ExceedLimitations/PawCare/README.md

# 🐾 PawCare — Smart IoT Pet Feeder Dashboard

A full-stack IoT system for monitoring and controlling an automatic pet feeder in real-time. Built with Node.js, Express, Socket.io, and MQTT on the backend; React + Vite on the frontend; Firebase Firestore as the cloud database; and an ESP32 microcontroller running custom Arduino firmware.

---

## Table of Contents

1. [Features](#features)
2. [Tech Stack](#tech-stack)
3. [Project Structure](#project-structure)
4. [Prerequisites](#prerequisites)
5. [Firebase Setup](#firebase-setup)
6. [Environment Variables](#environment-variables)
7. [Running Locally (Development)](#running-locally-development)
8. [Building for Production](#building-for-production)
9. [Deploying to Render (Backend)](#deploying-to-render-backend)
10. [Deploying to Netlify (Frontend-only)](#deploying-to-netlify-frontend-only)
11. [REST API Reference](#rest-api-reference)
12. [Socket.io Events](#socketio-events)
13. [MQTT Topics & Payloads](#mqtt-topics--payloads)
14. [Hardware & Wiring](#hardware--wiring)
15. [Firmware (ESP32)](#firmware-esp32)
16. [CI/CD — Automated Firmware Builds](#cicd--automated-firmware-builds)
17. [Over-the-Air (OTA) Updates](#over-the-air-ota-updates)
18. [Notification System](#notification-system)
19. [Security Model](#security-model)
20. [Troubleshooting](#troubleshooting)
21. [Changelog](#changelog)

---

## Features

| Feature | Description |
|---|---|
| **Real-time monitoring** | Live food-level gauge and device-online indicator via MQTT → Socket.io |
| **Manual dispensing** | Trigger a food dispense with a configurable portion (1–500 g) from the dashboard |
| **Physical button** | Press the on-device button to dispense; the event is logged to Firestore automatically |
| **Automated schedules** | Create, edit, enable/disable, and delete feeding schedules stored in Firestore; schedules fire even if the dashboard is closed |
| **Precise weight dispensing** | The ESP32 opens the hopper servo until the HX711 load cell confirms the target weight has dropped into the bowl |
| **Feeding history** | Logs every dispense (manual, scheduled, or physical) with timestamps and portion sizes; viewable as daily, weekly, and monthly charts |
| **Reservoir state notifications** | System alerts fire when the reservoir crosses into a new band: FULL ≥75%, SUFFICIENT 40–74%, LOW 1–39%, EMPTY 0% |
| **OS-level push notifications** | Service worker delivers real system notifications even when the tab is in the background or minimised |
| **Alerts & notifications** | Visual and OS-level warnings for food level changes, chute jams, and hardware events; persisted to Firestore with date + time |
| **Pet profile** | Store your pet's name, breed, age, birthday, and avatar photo |
| **OTA firmware updates** | Push new ESP32 firmware from the dashboard without physical access to the device |
| **Automated firmware builds** | GitHub Actions compiles `firmware.ino` on every push, updates `firmware/firmware.bin` and `firmware/version.json` automatically |
| **Overlap-safe dispensing** | A feed command that arrives while a dispense is already running (scheduled + button + duplicate MQTT, etc.) is ignored instead of resetting the state machine mid-cycle |
| **Empty-hopper detection** | If several dispense pulses in a row produce no measurable weight gain, the firmware gives up after ~3–4 s and raises a "hopper empty" alert instead of grinding through the full 35 s timeout |
| **JWT authentication** | All REST endpoints, Socket.io connections, and Netlify serverless functions require a signed JWT |
| **Rate limiting** | Login (10 req/min) and feed (30 req/min) endpoints are rate-limited |

---

## Tech Stack

| Layer | Technology | Version |
|---|---|---|
| **Backend runtime** | Node.js | ≥ 18 |
| **HTTP server** | Express | 4.x |
| **Real-time** | Socket.io | 4.x |
| **IoT messaging** | MQTT | 5.x |
| **Database** | Firebase Firestore (via `firebase-admin`) | 14.x |
| **Auth** | JSON Web Tokens (`jsonwebtoken`) | 9.x |
| **Rate limiting** | `express-rate-limit` | 8.x |
| **Frontend** | React + Vite | React 19, Vite 8 |
| **Charts** | Chart.js + `react-chartjs-2` | 4.x / 5.x |
| **Icons** | `lucide-react` | 1.x |
| **Push notifications** | Browser Service Worker (`sw.js`) | — |
| **Serverless (optional)** | Netlify Functions | — |
| **CI/CD** | GitHub Actions (`arduino-cli`) | — |
| **Dev server** | nodemon | 3.x |

---

## Project Structure

```
PawCare/
├── server.js                       # Express + Socket.io + MQTT + schedule runner
├── firmware.ino                    # ESP32 Arduino firmware (main sketch)
├── firmware/
│   ├── firmware.bin                # Compiled firmware binary (auto-generated by CI)
│   └── version.json                # OTA manifest: { "version": "x.y.z", "url": "..." }
├── .github/
│   └── workflows/
│       └── compile-firmware.yml    # CI: compiles firmware.ino → firmware.bin on every push
├── netlify/
│   └── functions/                  # Netlify serverless functions (static deployment)
│       ├── _firebase.js            # Shared Firestore initializer
│       ├── _helpers.js             # Shared response helpers + requireAuth() JWT check
│       ├── _data.js                # Unused — legacy mock-data helpers from an earlier no-DB version
│       ├── feed.js                 # POST /feed
│       ├── feedings-today.js       # GET /feedings/today
│       ├── feedings-weekly.js      # GET /feedings/weekly
│       ├── feedings-recent.js      # GET /feedings/recent
│       ├── sensor-history.js       # GET /sensor/history
│       ├── schedules.js            # GET & POST /schedules
│       ├── schedules-id.js         # PATCH & DELETE /schedules/:id
│       ├── status.js               # GET /status
│       └── profile.js              # GET & POST /profile
├── netlify.toml                    # Netlify build & redirect configuration
├── frontend/                       # React + Vite dashboard
│   ├── index.html
│   ├── vite.config.js              # Dev proxy → localhost:3000
│   ├── package.json
│   └── src/
│       ├── main.jsx
│       ├── App.jsx                 # Root component — all dashboard state & logic lives here
│       ├── index.css               # Global styles
│       ├── components/
│       │   └── MetricPanels.jsx    # Unused — not imported by App.jsx
│       └── hooks/
│           ├── useDashboard.js     # Unused — exports useNextFeed(), not imported by App.jsx
│           ├── useSocket.js        # Socket.io connection & event handlers (used)
│           └── useNotifications.js # Browser notification permission & SW delivery (used)
│   └── public/
│       └── sw.js                   # Service Worker: OS-level push notification handler
├── package.json                    # Server (backend) dependencies
├── .env.example                    # Template for your .env file
└── .gitignore
```

> **Note:** `netlify/functions/_data.js`, `frontend/src/components/MetricPanels.jsx`, and `frontend/src/hooks/useDashboard.js` are currently unreferenced by any code path — leftovers from an earlier iteration of the dashboard. They're harmless to leave in place, but don't expect edits there to have any effect until something actually imports them.

---

## Prerequisites

- [Node.js](https://nodejs.org/) **v18 or later** (both backend and frontend build)
- npm (bundled with Node)
- A **Firebase project** with Firestore enabled (see [Firebase Setup](#firebase-setup))
- An MQTT broker — the public HiveMQ broker (`broker.hivemq.com:1883`) works for development; use a private broker in production
- *(For firmware)* Arduino IDE with ESP32 board support and the libraries listed in [Firmware](#firmware-esp32)

---

## Firebase Setup

1. Go to [Firebase Console](https://console.firebase.google.com/) and create a new project (or use an existing one).
2. Enable **Cloud Firestore** in Native mode.
3. Go to **Project Settings → Service Accounts** and click **Generate new private key**. Save the downloaded JSON file as `firebase-service-account.json` in the project root.
4. In your `.env` file set:
   ```env
   GOOGLE_APPLICATION_CREDENTIALS=./firebase-service-account.json
   ```
   > **Tip for PaaS (Render, Railway, etc.):** Instead of uploading the file, paste the entire JSON content as a single-line string into the `FIREBASE_SERVICE_ACCOUNT` environment variable. The server reads this automatically.

The server will verify the Firestore connection on startup and crash with a helpful error if it cannot reach the database.

### Firestore Collections Used

| Collection | Purpose |
|---|---|
| `feedings` | One document per dispense event |
| `schedules` | One document per feeding schedule |
| `sensor_logs` | Sensor telemetry; `latest` document always holds the most recent reading |
| `notifications` | Persisted alert/notification records (includes `type`, `title`, `message`, `time`, `date`, `id`) |
| `config/profile` | Single document storing the pet profile |

---

## Environment Variables

Copy `.env.example` to `.env` and fill in your values:

```bash
cp .env.example .env
```

| Variable | Default | Required | Description |
|---|---|---|---|
| `PORT` | `3000` | No | HTTP server port |
| `MQTT_BROKER` | `mqtt://broker.hivemq.com:1883` | No | MQTT broker URL |
| `MQTT_TOPIC_STATUS` | `pawfeed/device01/status` | No | Hardware status updates |
| `MQTT_TOPIC_SENSOR` | `pawfeed/device01/sensor` | No | Sensor readings |
| `MQTT_TOPIC_CMD` | `pawfeed/device01/command` | No | Commands sent to hardware |
| `MQTT_TOPIC_ALERTS` | `pawfeed/device01/alerts` | No | Device alert messages |
| `MQTT_TOPIC_FEED_LOG` | `pawfeed/device01/feed_log` | No | Physical button feed events from device |
| `MQTT_TOPIC_OTA_STATUS` | `pawfeed/device01/ota_status` | No | OTA progress updates |
| `GOOGLE_APPLICATION_CREDENTIALS` | `./firebase-service-account.json` | **Yes*** | Path to Firebase service account JSON |
| `FIREBASE_SERVICE_ACCOUNT` | *(empty)* | **Yes*** | Firebase service account JSON as a string (PaaS alternative to the file) |
| `ADMIN_USER` | *(none)* | **Yes** | Dashboard login username |
| `ADMIN_PASS` | *(none)* | **Yes** | Dashboard login password |
| `JWT_SECRET` | *(none)* | **Yes** | JWT signing secret (use 32+ random characters) |
| `TZ` | `Asia/Manila` | No | Timezone for schedule execution and date labels |

> **\*** Either `GOOGLE_APPLICATION_CREDENTIALS` (file path) or `FIREBASE_SERVICE_ACCOUNT` (JSON string) must be provided. The server exits immediately if Firebase cannot initialize.

> **Security:** The server **refuses to start** if `ADMIN_USER`, `ADMIN_PASS`, or `JWT_SECRET` are missing. Never use default or weak values in production.

---

## Running Locally (Development)

### 1. Install dependencies

```bash
# Project root — backend deps
npm install

# Frontend deps
cd frontend
npm install
cd ..
```

### 2. Configure environment

```bash
cp .env.example .env
# Edit .env and fill in ADMIN_USER, ADMIN_PASS, JWT_SECRET, and Firebase credentials
```

### 3. Start the backend

```bash
npm run dev          # uses nodemon — auto-restarts on file changes
```

The backend runs at **http://localhost:3000**.

### 4. Start the frontend (separate terminal)

```bash
cd frontend
npm run dev          # Vite dev server — usually http://localhost:5173
```

The Vite dev server proxies all `/feed`, `/schedules`, `/status`, and socket requests to `localhost:3000`, so CORS is not an issue in development.

> **No hardware?** There is currently no simulated/demo data mode in the frontend — without a device publishing to MQTT, the dashboard will show zeroed-out stats (0% food level, no recent feedings) rather than synthetic data. `netlify/functions/_data.js` contains leftover mock-data generators from an earlier iteration that did this, but nothing imports it today.

---

## Building for Production

```bash
cd frontend
npm run build        # outputs to frontend/dist/
```

In production mode the Express server at the project root serves the built React app from `frontend/dist/`. You only need to run the backend:

```bash
npm start            # runs node server.js
```

---

## Deploying to Render (Backend)

Render is the recommended platform for the full-stack deployment (backend + Firebase + MQTT).

1. Push the repo to GitHub.
2. Create a new **Web Service** on [Render](https://render.com/) pointing to your repo.
3. Set the build command to:
   ```
   npm install && cd frontend && npm install && npm run build
   ```
4. Set the start command to:
   ```
   node server.js
   ```
5. Add all environment variables from the table above in the Render dashboard.
6. For Firebase credentials on Render, paste the entire service account JSON into the `FIREBASE_SERVICE_ACCOUNT` environment variable.

The live URL (`https://pawcare-rcd9.onrender.com`) is already embedded in the firmware as the OTA endpoint.

---

## Deploying to Netlify (Frontend-only)

Netlify is supported for a **static + serverless** deployment where the frontend and API functions are both served from Netlify's CDN (no persistent backend — MQTT real-time is not available in this mode).

```bash
# Install Netlify CLI
npm install -g netlify-cli

# Authenticate and link your site
netlify login
netlify link

# Run locally with Netlify Functions
npm run netlify-dev
```

`netlify.toml` maps all API routes (e.g., `/feed`, `/schedules`) to the corresponding functions in `netlify/functions/`. The SPA fallback rule serves `index.html` for all unmatched paths.

> **Note:** Socket.io real-time updates and the schedule runner are only available with the full Node.js backend on Render (or equivalent). The Netlify deployment is suitable for read-only or limited-write dashboards without live sensor streaming.

> **⚠️ No `/login` function exists on Netlify.** Every Netlify function requires the same `Authorization: Bearer <JWT>` header that `server.js` enforces (see [Security Model](#security-model)), but `netlify/functions/` has no login handler and `netlify.toml` has no redirect for `/login` — so the dashboard's login screen has nothing to submit to and will 404 on a Netlify-only deployment. To use this mode today you need to either:
> - Mint a token from a running Node backend's `POST /login` (same `JWT_SECRET` configured on both sides) and set it manually via the browser console: `localStorage.setItem('pawcare_auth', '<token>')`, or
> - Add a `netlify/functions/login.js` that mirrors `server.js`'s `/login` handler and wire it up in `netlify.toml`.
>
> Until one of those is done, treat the Netlify deployment as a functions-only backend for a separately-hosted frontend/session, not a fully self-contained deployment.

---

## REST API Reference

All endpoints except `GET /health`, `POST /login`, `GET /firmware/version.json`, and `GET /firmware/firmware.bin` require a `Bearer <token>` header.

### Authentication

| Method | Endpoint | Description |
|---|---|---|
| `POST` | `/login` | Obtain a JWT. Body: `{ "username": "admin", "password": "..." }`. Returns `{ "success": true, "token": "..." }`. Token expires in 8 hours. |
| `GET` | `/health` | Liveness probe. Returns `{ "ok": true, "ts": <epoch_ms> }`. |

### Feeding

| Method | Endpoint | Auth | Description |
|---|---|---|---|
| `POST` | `/feed` | ✅ | Dispatch a food dispense. Body: `{ "portion": 80, "type": "manual" }`. Portion clamped to 1–500 g; defaults to 45 g if omitted or invalid. Rate-limited to 30 req/min. |
| `GET` | `/feedings/today` | ✅ | Today's total feed count and grams. |
| `GET` | `/feedings/recent` | ✅ | Last 50 feeding records (newest first). |
| `GET` | `/feedings/weekly` | ✅ | Daily totals for the past 7 days (zero-padded). |
| `GET` | `/feedings/monthly` | ✅ | Daily totals for the past 30 days (zero-padded). |
| `GET` | `/feedings/daily` | ✅ | Hourly breakdown for today. |

### Sensor & Status

| Method | Endpoint | Auth | Description |
|---|---|---|---|
| `GET` | `/status` | ✅ | Latest sensor snapshot from Firestore. |
| `GET` | `/sensor/history` | ✅ | Daily average food level for the past 7 days. |

### Schedules

| Method | Endpoint | Auth | Description |
|---|---|---|---|
| `GET` | `/schedules` | ✅ | List all feeding schedules. |
| `POST` | `/schedules` | ✅ | Create a new schedule. Body: `{ "label": "Morning", "time": "08:00", "portion_g": 80, "days": "daily" }`. `days` accepts `"daily"`, `"weekdays"`, or `"weekends"`. |
| `PATCH` | `/schedules/:id` | ✅ | Update a schedule field. Any subset of `{ label, time, portion_g, days, enabled }`. |
| `DELETE` | `/schedules/:id` | ✅ | Delete a schedule. |

### Notifications

| Method | Endpoint | Auth | Description |
|---|---|---|---|
| `GET` | `/notifications` | ✅ | Last 100 notifications (newest first). |
| `POST` | `/notifications` | ✅ | Save a notification. Body: `{ "id", "type", "title", "message", "time", "date" }`. |
| `DELETE` | `/notifications` | ✅ | Clear all notifications. |
| `DELETE` | `/notifications/:id` | ✅ | Dismiss a single notification. |

### Pet Profile

| Method | Endpoint | Auth | Description |
|---|---|---|---|
| `GET` | `/profile` | ✅ | Retrieve pet profile (`name`, `breed`, `avatar`, `birthday`, `age`). |
| `POST` | `/profile` | ✅ | Save/update pet profile. Accepts Base64 avatar image (up to 10 MB). |

### Firmware (OTA)

| Method | Endpoint | Auth | Description |
|---|---|---|---|
| `GET` | `/firmware/version.json` | ❌ | Returns the OTA version manifest. |
| `GET` | `/firmware/firmware.bin` | ❌ | Streams the compiled firmware binary to the ESP32. |
| `POST` | `/firmware/update` | ✅ | Sends an `ota_update` MQTT command to trigger an OTA check on the device. |

---

## Socket.io Events

The frontend connects with its JWT in the handshake auth: `{ auth: { token } }`.

### Events emitted **by the server** to clients

| Event | Payload | Description |
|---|---|---|
| `status` | `{ food_level, jammed, last_dispensed_g, dispense_success, bowl_weight, online, fw_version }` | Real-time sensor update from device |
| `feeding_done` | `{ id, timestamp, portion_g, type, label? }` | Confirmed dispense (any source) |
| `alert` | `{ level: "error" \| "warning", message: "..." }` | Hardware alert from device |
| `mqtt_status` | `{ connected: true \| false }` | MQTT broker connectivity change |
| `ota_status` | `{ status, version?, error? }` | OTA firmware update progress |
| `tare_ack` | `{ timestamp }` | Scale tare command acknowledged |
| `error` | `{ message }` | Socket-level error (e.g., rate limit exceeded) |

### Events emitted **by clients** to the server

| Event | Payload | Description |
|---|---|---|
| `feed` | `{ portion: 80, type: "manual" }` | Trigger a dispense (rate-limited: 30/min) |
| `tare` | *(none)* | Zero the load cell scale |

---

## MQTT Topics & Payloads

All topics use the prefix configured via `MQTT_TOPIC_*` environment variables (default: `pawfeed/device01`).

### Server → Device (`/command`)

```json
{ "action": "feed",       "portion_g": 80 }
{ "action": "tare" }
{ "action": "ota_update" }
```

### Device → Server (`/status`) — sent once on MQTT connect

```json
{ "food_level": 72, "jammed": false, "online": true, "fw_version": "1.3.17" }
```

### Device → Server (`/sensor`) — periodic telemetry (every ~4 s, and during a dispense)

```json
{
  "food_level": 72,
  "jammed": false,
  "last_dispensed_g": 50.1,
  "dispense_success": true,
  "bowl_weight": 122.5,
  "fw_version": "1.3.17"
}
```

### Device → Server (`/feed_log`) — Physical button only

```json
{ "type": "physical", "portion_g": 100 }
```

### Device → Server (`/alerts`)

```json
{ "alert_message": "Hopper jammed — check dispenser chute" }
```

### Device → Server (`/ota_status`)

The `status` field is one of `checking`, `downloading`, `up_to_date`, `success`, or `failed`. `version` and `error` are only present when relevant:

```json
{ "status": "checking" }
{ "status": "downloading", "version": "1.3.17" }
{ "status": "up_to_date",  "version": "1.3.17" }
{ "status": "success",     "version": "1.3.17" }
{ "status": "failed",      "error": "HTTP 404" }
{ "status": "failed",      "error": "Malformed version.json" }
```

---

## Hardware & Wiring

Flash `firmware.ino` to your ESP32 and wire the components according to the table below.

| Component | ESP32 Pin | Notes |
|---|---|---|
| **Servo Motor (Dispenser gate)** | `GPIO 13` | Controls chute opening via `ESP32Servo` / ledc PWM |
| **HC-SR04 Ultrasonic — Trigger** | `GPIO 5` | Measures hopper fill level |
| **HC-SR04 Ultrasonic — Echo** | `GPIO 18` | Use a 5V → 3.3V logic level shifter |
| **IR Jam Sensor (FC-51 / break-beam)** | `GPIO 19` | `INPUT_PULLUP`; `IR_JAM_STATE = LOW` for reflectance modules, `HIGH` for break-beam |
| **HX711 Load Cell — DOUT** | `GPIO 21` | Scale data output |
| **HX711 Load Cell — SCK** | `GPIO 22` | Scale clock |
| **Piezo Buzzer** | `GPIO 4` | Non-blocking PWM via ledc; auditory feedback on dispense and errors |
| **Status LED** | `GPIO 2` | Solid = online; fast blink = WiFi portal open |
| **Alert/Error LED** | `GPIO 15` | Flashes on jam or dispense failure |
| **Manual Dispense Button** | `GPIO 14` | Short press = dispense; hold 3 s at boot = WiFi reset |

> **LEDC channel/timer gotcha:** the servo (`SERVO_CHANNEL`) and buzzer (`BUZZER_CHANNEL`) are both driven via the ESP32 core 2.x `ledcSetup`/`ledcWrite`/`ledcWriteTone` API, **not** the `ESP32Servo` library. On this core, LEDC channels share an underlying timer in pairs: `timer = (channel/2) % 4`. Channels `0` and `1` share a timer — if the servo and buzzer were ever assigned to that pair (as they were until firmware v1.3.16), `ledcWriteTone()` beeping the buzzer would silently reprogram the shared timer's frequency out from under the servo's 50 Hz PWM signal, corrupting it (typically the servo stops responding entirely) for as long as the tone lasted. `SERVO_CHANNEL = 2` and `BUZZER_CHANNEL = 0` currently sit on separate timers — if you ever add another `ledcSetup()`-based peripheral, pick a channel outside `{0,1}` (whichever timer the buzzer/servo don't already use) or move to `ESP32Servo`, which manages its own timer allocation.

### Hopper Ultrasonic Calibration

The firmware maps the HC-SR04 distance reading to a 0–100% food level using Arduino's `map()` + `constrain()`:

```cpp
level = constrain(map(dist, HOPPER_FULL_CM, HOPPER_EMPTY_CM, 100, 0), 0, 100);
```

| Constant | Value | Meaning |
|---|---|---|
| `HOPPER_FULL_CM` | `2 cm` | Distance sensor → food surface when hopper is **full** (100%) |
| `HOPPER_EMPTY_CM` | `9 cm` | Distance sensor → hopper bottom when **completely empty** (0%) |

> **Calibration history:**
> - Originally `20 cm` — caused ~50% to display when actually empty
> - Updated to `11 cm` — caused ~22% to display when actually empty  
> - Recalibrated to `9 cm` — correctly maps the physical empty reading to 0%

**To recalibrate:** Empty the hopper completely, open the lid, and read the distance from the Arduino Serial Monitor. Set `HOPPER_EMPTY_CM` to that value (or slightly lower so `constrain()` clamps any variation to 0%).

**Back-calculation formula** (if you know the displayed % but not the cm):
```
dist = HOPPER_FULL_CM + (1 - displayed% / 100) × (HOPPER_EMPTY_CM - HOPPER_FULL_CM)
```

### Servo Gate Calibration

| Constant | Value | Meaning |
|---|---|---|
| `SERVO_CLOSED` | `90°` | Gate sealed — food held in hopper |
| `SERVO_OPEN` | `20°` | Gate fully open — food falls to bowl |

Adjust these angles if your servo mechanical linkage is different.

---

## Firmware (ESP32)

### Required Arduino Libraries

Install these via Arduino Library Manager (Sketch → Include Library → Manage Libraries):

| Library | Author |
|---|---|
| `WiFiManager` | tzapu |
| `PubSubClient` | Nick O'Leary |
| `ArduinoJson` | Benoit Blanchon |
| `HX711 Arduino Library` | bogde |

The following are built into the ESP32 Arduino core and do not need separate installation: `WiFi`, `Preferences`, `HTTPUpdate`, `WiFiClientSecure`.

> **`ESP32Servo` is not actually used.** `compile-firmware.yml` still installs it and it doesn't hurt to have on your machine, but `firmware.ino` doesn't `#include` it — the servo gate is driven directly via the ESP32 core's built-in `ledcSetup`/`ledcAttachPin`/`ledcWrite` API (see `setServoAngle()`). See the LEDC timer-sharing note in [Hardware & Wiring](#hardware--wiring) if you're touching servo/buzzer PWM code.

### First Boot — WiFi Setup

On first boot (or after a WiFi reset), the ESP32 opens a captive-portal access point:

- **SSID:** `PawCare-Setup`
- **Password:** `pawcare123`

Connect with your phone or laptop, open any browser, and you will be redirected to a configuration page where you can enter:

- Your home Wi-Fi SSID and password
- MQTT Server address
- MQTT Port
- Topic Prefix (e.g., `pawfeed/device01`)

All settings are saved to ESP32 NVS flash and survive reboots. To reset WiFi and re-open the portal, hold the button on `GPIO 14` for **3 seconds at boot**.

### Key Firmware Constants

| Constant | Current Value | Description |
|---|---|---|
| `FIRMWARE_VERSION` | `"1.3.17"` | Must match `firmware/version.json` to avoid boot-loop OTA |
| `OTA_VERSION_URL` | `https://pawcare-rcd9.onrender.com/firmware/version.json` | Where the device checks for updates |
| `HOPPER_FULL_CM` | `2` | HC-SR04 reading (cm) when hopper is full → 100% |
| `HOPPER_EMPTY_CM` | `9` | HC-SR04 reading (cm) when hopper is empty → 0% |
| `calibration_factor` | `418.95` | HX711 scale calibration; adjust until `1 g = 1 g` in Serial Monitor |
| `targetWeight` | `45` g | Default portion if no `portion_g` arrives from dashboard |
| `emptyThreshold` | `10` % | Food level below which hopper is considered "empty" for LED/alert logic |
| `jamTimeout` | `1500` ms | Time IR sensor must be blocked before declaring a jam |
| `IR_JAM_STATE` | `LOW` | Flip to `HIGH` for break-beam IR sensors |
| `SERVO_CLOSED` | `90°` | Servo angle for sealed gate |
| `SERVO_OPEN` | `20°` | Servo angle for fully open gate |

### Non-Blocking Dispense State Machine

`handleDispenser()` runs on every `loop()` iteration and drives dispensing through a state machine (`DISPENSE_IDLE → DISPENSE_INIT → DISPENSE_SETTLE → DISPENSE_PULSE_OPEN ⇄ DISPENSE_PULSE_SETTLE → DISPENSE_FINAL_SETTLE → DISPENSE_EVALUATE → DISPENSE_IDLE`) instead of blocking with `delay()`. Each pulse briefly opens the gate for a duration proportional to the remaining weight, then closes it and waits for the HX711 reading to settle before deciding whether to pulse again.

| Constant | Value | Description |
|---|---|---|
| `PULSE_MS_PER_GRAM` | `8` ms/g | Pulse duration scales with grams remaining |
| `PULSE_MIN_MS` / `PULSE_MAX_MS` | `100` / `300` ms | Clamp range for a single pulse's open duration |
| `PULSE_SETTLE_MS` | `700` ms | Wait after closing the gate for the load cell reading to stabilize before pulsing again |
| `DISPENSE_DONE_G` | `0.5` g | Remaining weight below which the dispense is considered complete |
| `DISPENSE_STALL_PULSES` | `4` | Consecutive pulses with negligible weight gain before aborting as "hopper empty" (v1.3.17+) |
| `DISPENSE_STALL_GAIN_G` | `1.0` g | Minimum weight gain per pulse needed to reset the stall counter (v1.3.17+) |
| *(hard timeout)* | `35000` ms | Absolute ceiling on any single dispense attempt, regardless of state |

**Two safeguards worth knowing about if you're debugging a stuck feeder:**
- **Overlap guard (v1.3.16+):** a feed command that arrives while `dispState != DISPENSE_IDLE` is ignored rather than resetting the state machine — this used to unconditionally clear `systemJammed` and restart from `DISPENSE_INIT`, which could force the auger against an unresolved jam or double-dispense.
- **Empty-hopper stall detection (v1.3.17+):** the IR sensor only catches jams (something physically blocking the beam) — it never fires when the hopper is simply empty, since there's nothing there to block. `DISPENSE_PULSE_SETTLE` separately tracks weight gain across pulses and aborts after `DISPENSE_STALL_PULSES` consecutive pulses below `DISPENSE_STALL_GAIN_G`, instead of grinding through the full 35 s timeout on every attempt.

---

## CI/CD — Automated Firmware Builds

The GitHub Actions workflow at `.github/workflows/compile-firmware.yml` automatically compiles and deploys firmware on every push to `main` that touches `firmware.ino`.

### What the workflow does

1. **Checks out** the repository
2. **Installs** `arduino-cli` and the ESP32 Arduino core (`esp32:esp32@2.0.17`)
3. **Installs** all required libraries (`WiFiManager`, `PubSubClient`, `ArduinoJson`, `ESP32Servo`, `HX711 Arduino Library`)
4. **Compiles** `firmware.ino` for the `esp32:esp32:esp32` board target
5. **Copies** the compiled binary to `firmware/firmware.bin`
6. **Syncs** `firmware/version.json` — reads the `#define FIRMWARE_VERSION` string from `firmware.ino` and writes it into the JSON automatically
7. **Commits and pushes** the updated `firmware/firmware.bin` and `firmware/version.json` back to `main`

### How to trigger a firmware release

You only need to **bump `FIRMWARE_VERSION` in `firmware.ino`** and push. Everything else is automatic:

```cpp
// firmware.ino
#define FIRMWARE_VERSION  "1.3.18"   // ← change this
```

```bash
git add firmware.ino
git commit -m "chore: bump firmware version 1.3.17 -> 1.3.18"
git push origin main
# GitHub Actions picks it up, compiles, and pushes firmware.bin + version.json
```

After the workflow completes (~3–5 minutes), trigger an OTA update from the dashboard to push it to the device.

> **Important:** `FIRMWARE_VERSION` in `firmware.ino` must always match the `version` field in `firmware/version.json`. If they differ (e.g., you manually edited `version.json`), the device will enter a boot-loop OTA. The CI workflow keeps them in sync automatically as long as you only bump `firmware.ino`.

---

## Over-the-Air (OTA) Updates

PawCare supports pushing new firmware to the ESP32 without physical access.

### Automated workflow (recommended)

1. Bump `FIRMWARE_VERSION` in `firmware.ino` and push to `main`
2. GitHub Actions compiles and updates `firmware/firmware.bin` + `firmware/version.json` automatically
3. Render redeploys from the new commit (if auto-deploy is enabled)
4. Click **Update Firmware** in the dashboard — sends `{ "action": "ota_update" }` via MQTT
5. The device fetches the version manifest, compares versions, downloads the binary over HTTPS, and reboots

### Manual workflow

1. Compile in Arduino IDE: **Sketch → Export Compiled Binary** → copy the `.bin` to `firmware/firmware.bin`
2. Update `firmware/version.json`:
   ```json
   { "version": "1.3.18", "url": "https://pawcare-rcd9.onrender.com/firmware/firmware.bin" }
   ```
3. Bump `FIRMWARE_VERSION` in `firmware.ino` to the **same** string
4. Deploy the updated server (with the new `firmware/` files) to Render
5. Click **Update Firmware** in the dashboard

OTA progress is streamed back to the dashboard via the `ota_status` MQTT topic.

---

## Notification System

### Reservoir State Notifications

The dashboard monitors `food_level` and fires a notification whenever the reservoir crosses into a new state band. Notifications are **suppressed on page load** — they only fire on genuine level changes after the initial status fetch.

| State | Threshold | Alert Type | Color |
|---|---|---|---|
| **FULL** | ≥ 75% | `success` | 🟢 Green |
| **SUFFICIENT** | 40–74% | `info` | 🔵 Blue |
| **LOW** | 1–39% | `warning` | 🟡 Amber |
| **EMPTY** | 0% | `error` | 🔴 Red |

### All Alert Types & Colors

| Type | Used for | Color |
|---|---|---|
| `success` | Food Dispensed, Reservoir Full, Firmware Updated | 🟢 `var(--status-ok)` |
| `info` | Reservoir Sufficient, OTA Update Triggered | 🔵 `#2563EB` |
| `warning` | Reservoir Low, System Notice | 🟡 `var(--status-warning)` |
| `error` | Reservoir Empty, Feeder Jammed, OTA Failed, errors | 🔴 `var(--status-error)` |

### OS-Level Push Notifications (Service Worker)

`frontend/public/sw.js` is a Service Worker that delivers real OS-level notifications even when the browser tab is in the background, minimised, or the screen is locked. It works on desktop Chrome/Firefox and Android Chrome.

**Flow:**
1. User grants notification permission via the bell icon in the navbar
2. `useNotifications.js` registers the Service Worker and stores the registration
3. When `addAlert()` is called, it posts a `{ type: 'NOTIFY', title, body, tag, icon }` message to the SW
4. The SW calls `self.registration.showNotification()` — a real OS tray notification appears
5. Clicking the OS notification focuses the PawCare tab (or opens a new one)

### Notification Persistence

Every notification is saved to the `notifications` Firestore collection (via `POST /notifications` in `server.js`) with:
- `id` — unique string; the frontend generates it as `Date.now()` + 5 random base36 chars, so it always embeds a millisecond timestamp
- `type` — `success` | `info` | `warning` | `error`
- `title` — short heading
- `message` — full description
- `time` — `HH:MM:SS`, computed client-side in Asia/Manila before the request is sent
- `timestamp` — full ISO 8601 string, generated server-side at save time

Notifications persist across page reloads and are loaded on startup (`GET /notifications`, last 100, newest first). **Note:** `server.js` does not persist a `date` field at all — only `id`, `type`, `title`, `message`, `time`, and `timestamp` are written to Firestore. The System Notifications panel always derives the displayed date client-side from the millisecond timestamp embedded in `id` (falling back to `date` if a document happens to have one, e.g. from a different write path). This isn't a fallback for "older" records — it's the only way a date ever gets displayed today.

---

## Security Model

| Area | Mechanism |
|---|---|
| **Dashboard login** | Username + password validated against `ADMIN_USER` / `ADMIN_PASS` env vars |
| **API auth** | JWT signed with `JWT_SECRET`; 8-hour expiry; all routes except login/health/OTA download require `Authorization: Bearer <token>` |
| **Netlify Functions auth** | Every function in `netlify/functions/` calls the same JWT check (`requireAuth()` in `_helpers.js`) as `server.js`'s `authenticate` middleware — requires `JWT_SECRET` to also be set in the Netlify site's environment variables, or every function returns `500`. See the login caveat in [Deploying to Netlify](#deploying-to-netlify-frontend-only). |
| **Socket.io auth** | JWT verified in Socket.io middleware on every connection |
| **Rate limiting** | Login: 10 req/min; Feed (HTTP): 30 req/min; Feed (Socket): 30 events/min per socket |
| **Startup guard** | Server refuses to start if `ADMIN_USER`, `ADMIN_PASS`, or `JWT_SECRET` are unset |
| **Portion clamping** | Portion values are clamped to 1–500 g server-side regardless of what the client sends |
| **OTA endpoints** | Firmware download endpoints are public (ESP32 cannot send auth headers), but they only serve static files |
| **Firestore** | Access is server-side only via Firebase Admin SDK; Firestore Security Rules should be set to deny all direct client access |

---

## Troubleshooting

### Server won't start

- **"ADMIN_USER, ADMIN_PASS, and JWT_SECRET must be set"** — Add these to your `.env` file.
- **Firebase initialization fails** — Check that `firebase-service-account.json` exists or `FIREBASE_SERVICE_ACCOUNT` is set correctly. Ensure Firestore is created in the Firebase Console.
- **Firestore connection FAILED** — Visit the link in the error message and create the database if it doesn't exist.

### Dashboard shows demo mode / no live data

- The device is not connected to MQTT. Check the ESP32 Serial Monitor — it should print `[MQTT] Connected` and start publishing sensor data.
- Verify the MQTT broker and topic prefix match between the server `.env` and the firmware NVS values.

### ESP32 cannot connect to WiFi

- Hold `GPIO 14` button for 3 seconds at boot to reset WiFi and re-open the captive portal.

### Servo doesn't turn (or moves erratically) when dispensing

- This was a real bug, fixed in firmware v1.3.16: `SERVO_CHANNEL` and `BUZZER_CHANNEL` used to be assigned to LEDC channels that shared the same underlying hardware timer on ESP32 core 2.x. Every buzzer beep (`ledcWriteTone()`) silently reprogrammed that shared timer's frequency, corrupting the servo's 50 Hz PWM signal for as long as the tone lasted — and `startBeeps(2, 100)` fires at the very start of every dispense. If you've since added another `ledcSetup()`-based peripheral and the servo stops responding again, check whether its channel shares a timer with the servo or buzzer (`timer = (channel/2) % 4`) — see [Hardware & Wiring](#hardware--wiring).

### Dispensing seems unresponsive / repeated button presses do nothing

- If the hopper is genuinely empty, firmware ≤ v1.3.15 would pulse the auger uselessly for the full 35 s hard timeout on every attempt. Combined with the overlap guard added in v1.3.16 (which correctly ignores a feed command that arrives while a dispense is already running), retries during that 35 s window did nothing and looked like the feeder had stopped responding.
- Fixed in v1.3.17: the dispenser now tracks weight gain across pulses and aborts after `DISPENSE_STALL_PULSES` (4) consecutive pulses with less than `DISPENSE_STALL_GAIN_G` (1 g) of progress, firing a "HOPPER EMPTY" alert within ~3–4 s instead of waiting the full 35 s.
- If it's still happening on v1.3.17+, check the Serial Monitor for `[Dispense]` log lines — a real mechanical jam (IR beam blocked) is reported separately as `CRITICAL FAULT: Mechanical Jam Detected` and requires physically clearing the chute.

### Food level reads inaccurately

- Recalibrate `HOPPER_EMPTY_CM` using the Serial Monitor: empty the hopper, open the lid, note the distance reading, and set `HOPPER_EMPTY_CM` to that value.
- **Back-calculation:** if the displayed % at true empty is `P`, the actual sensor distance is: `dist = 2 + (1 - P/100) × (HOPPER_EMPTY_CM - 2)`
- Current calibrated values: `HOPPER_FULL_CM = 2`, `HOPPER_EMPTY_CM = 9`

### Scale weight is inaccurate

- Adjust `calibration_factor` in `firmware.ino` until the reported weight matches a known reference weight. After changing it, bump `FIRMWARE_VERSION` and let CI rebuild.

### Reservoir notifications fire on every page reload

- This was a known bug (fixed in v1.3.13). The `statusReady` ref gates the reservoir notification effect so it only activates after the initial `/status` fetch completes, preventing the default `food_level: 0` from triggering a spurious alert on mount.

### Notifications show no date

- `server.js` never writes a `date` field to Firestore (see [Notification Persistence](#notification-system)) — this isn't a migration gap, it's how the current code works. The dashboard always derives the displayed date client-side from the millisecond timestamp embedded in the notification's `id`, so this requires no fix and no migration.

### OTA update fails

- Ensure `FIRMWARE_VERSION` in `firmware.ino` matches the version in `firmware/version.json` after an update (mismatch causes a boot-loop).
- If using CI, this is handled automatically — just bump `FIRMWARE_VERSION` in `firmware.ino` and push.
- Verify the `OTA_VERSION_URL` is reachable from the device's network.

### Netlify deployment: login screen won't work / every API call returns 401

- Expected with the current code — see the warning in [Deploying to Netlify](#deploying-to-netlify-frontend-only). There is no `/login` Netlify function, so the dashboard's login form has nothing to submit to. Either mint a token from a Node backend's `/login` and set it manually (`localStorage.setItem('pawcare_auth', '<token>')`), or add a `netlify/functions/login.js`.
- If you *do* have a token and are still getting 401/500s, confirm the Netlify site's environment variables include the same `JWT_SECRET` as whatever issued the token — a mismatch fails verification, and a missing `JWT_SECRET` makes every function return `500` before it even checks the token.

### GitHub Actions compile fails

- Check the Actions tab for errors. Common causes:
  - Missing library — add it to the `arduino-cli lib install` step in `compile-firmware.yml`
  - Syntax error in `firmware.ino` — fix the compile error locally first
  - Permissions issue — ensure the workflow has `contents: write` permission (already configured)

---

## Changelog

Firmware version and notable fixes since this README was last brought up to date (previously pinned at v1.3.13). Backend/frontend/Netlify fixes don't carry a version number but are dated here for reference.

| Version / Date | Change |
|---|---|
| **v1.3.14** | Servo de-energize between dispenses; ultrasonic read rate-limited during dispensing (it blocks ~30ms/call, which was starving the dispense state machine of weight checks); stale comment cleanup. |
| **v1.3.15** | Re-attach the servo's LEDC pin on every dispense — a workaround for `ledcWrite(channel, 0)` appearing to halt the channel on ESP32 core 2.x. (Superseded by the real root-cause fix in v1.3.16, below.) |
| **v1.3.16** | **Root cause of "servo doesn't turn":** `SERVO_CHANNEL` and `BUZZER_CHANNEL` shared an LEDC timer, so every beep corrupted the servo's PWM signal — moved the servo to a non-conflicting channel (see [Hardware & Wiring](#hardware--wiring)). Also added the dispense overlap guard (an in-flight or jammed dispense no longer gets silently reset by a new feed command) and a `failed` OTA status on malformed `version.json` (previously left the dashboard's OTA badge stuck on "Checking..."). |
| **v1.3.17** | Empty-hopper stall detection — abort a dispense after ~3–4 s of no weight progress instead of running the full 35 s hard timeout on every attempt (see [Non-Blocking Dispense State Machine](#non-blocking-dispense-state-machine)). |
| **2026-09-03 (backend/Netlify)** | Added JWT auth (`requireAuth()`) to every Netlify Function — they previously had none, unlike the identical `server.js` routes, so anyone reaching the Netlify deployment could trigger dispenses or edit schedules/profile unauthenticated. Also fixed `feed.js`'s default MQTT command topic (didn't match the device's actual topic), `profile.js` silently dropping `birthday`/`age` on save, and a timezone double-shift in `server.js`'s `padDays()` that could mislabel dates on the weekly/monthly chart. |
| **2026-09-03 (frontend)** | "Today" feeding count now re-syncs from the server when the Manila-local date rolls over, instead of drifting forever if a tab is left open past midnight. Feeding-timeline "completed" matching now checks time as well as label, so two schedules sharing a label no longer mark each other complete/missed. |
| **chore** | Removed `rewrite_firmware.py` — a one-off, already-applied migration script hardcoded to another contributor's local path. |

For the full commit-level history, see `git log`.

---

## License

MIT
