ExceedLimitations/PawCare/(commit log)

2026-06-21 dashboard redesign, tech migration, updated security
    [firmware.ino]
2026-06-24 Firmware updates and Server calibrations
2026-06-30 fixed button not reflecting in dashboard and minor improvements
    [firmware.ino]
2026-06-30 Updated time sync to esp32
2026-07-16 Added OTA to firmware and more calibrations
2026-07-17 Servo fixes
2026-07-17 Fix MQTT retained status
    [firmware.ino]
2026-07-17 Fix arduino-cli path and bump to 1.0.6
    [firmware.ino]
2026-07-17 Fix Arduino sketch folder name and bump to 1.0.7
    [firmware.ino]
2026-07-17 Fix Wi-Fi servo twitch and OTA success status
    [firmware.ino]
2026-07-17 Refactor servo logic to use openHopper and closeHopper
2026-07-17 Fix load cell lockout during dispense
    [firmware.ino]
2026-07-17 Ultrasonic and Dispense fixes
    [firmware.ino]
2026-07-17 UI and firmware fixes v1.1.4
    [firmware.ino]
2026-07-17 Fix tare blocking and dispense accuracy (v1.1.10)
    [firmware.ino]
2026-07-17 Fix potential Arduino IDE compilation errors with default arguments and variable scope (v1.1.13)
    [firmware.ino]
2026-07-22 minor fixes + v1.1.15
    [firmware.ino]
2026-07-26 added notification for firmware update and fixed issue with food level being 50% when empty v1.1.21
    [firmware.ino]
2026-07-27 bug fixes and improvements v1.2.0
    [firmware.ino]
2026-07-27 fix esp32 v3 ledc API compatibility
    [firmware.ino]
2026-07-27 servo fixes v1.2.1
2026-07-27 Fix servo attach bug and bump version to 1.2.3
    [firmware.ino]
2026-07-27 Bypass buggy ESP32Servo library using native ESP32 PWM, mute jam buzzer
    [firmware.ino]
2026-07-27 Fix load cell oscillation by using median filtered global weight during dispense
    [firmware.ino]
2026-07-28 Fix AZT during active dispense and add debug prints
    [firmware.ino]
2026-07-28 fix: dispense accuracy and IR jam debouncing
    - BULK phase now transitions to TRICKLE_WAIT instead of TRICKLE_OPEN to prevent uncontrolled food fall
    - Trickle open burst reduced from 100ms to 40ms to limit overshoot
    - Dispensing now uses raw median weight instead of EMA-smoothed weight to eliminate lag
    - Passive jam detection now requires 20 consecutive IR blocked readings before starting jam timer
    - Active jam detection during dispense now requires 5 consecutive blocked readings
    - Bump firmware version to 1.2.8
    [firmware.ino]
2026-07-28 Fix active jam detection false positives and remove blind hopper dump
    [firmware.ino]
2026-07-28 Fix dispense lag bugs: skip ultrasonic reads while dispensing and sync weight earlier
    [firmware.ino]
2026-07-28 Fix variable scoping issue for ultrasonic sensor alerts
    [firmware.ino]
2026-07-28 Bump firmware version to 1.3.1 for compiler fix deployment
    [firmware.ino]
2026-07-29 Fix HX711 interrupt issues, refactor dispense logic to adaptive pulses, and bump version to 1.3.2
    [firmware.ino]
2026-07-29 Calibrate dispenser pulse variables to prevent overshoot
    [firmware.ino]
2026-07-29 Bump firmware version to 1.3.3 for calibration defaults
2026-07-29 Increase PULSE_MIN_MS to 150ms to account for servo travel latency
2026-07-29 Fix physical button dispense log to always show 45g target weight
    [firmware.ino]
2026-07-29 Increase pulse settle delay to 1200ms to allow food to land and scale to stabilize
    [firmware.ino]
2026-08-26 feat: real OS notifications + jam buzzer alert
    - Add service worker (sw.js) for background system notifications
    - Fires OS-level popups even when tab is minimised or in background
    - Clicking notification brings dashboard tab into focus
    - Add useNotifications hook to manage SW registration and permission state
    - Wire notify() into addAlert() so every system event triggers a real
    OS notification (food dispensed, jam, low food, OTA status)
    - Add bell icon to navbar (green=granted, grey=click to enable, red=blocked)
    - Remove old silent Notification.requestPermission() call
    - Firmware: activate jam buzzer beep-beep-beep on IR blockage
    - 300ms on / 300ms off continuous beep at 2500Hz while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
    [firmware.ino]
2026-08-26 fix: firmware compile, notification delivery, and version badge
    firmware.ino:
    - Replace ledcWriteTone() (removed in ESP32 core 3.x) with
    ledcChangeFrequency() + ledcWrite() for buzzer tone/silence
    - Replace corrupted fake ISRG Root X1 certificate with correct cert
    so HTTPS OTA downloads actually succeed at runtime
    .github/workflows/compile-firmware.yml:
    - Switch board manager URL to official Espressif endpoint
    - Pin esp32:esp32 to 2.0.17 to prevent future 3.x API breakage
    frontend/src/App.jsx:
    - Normalise version strings (strip leading 'v') before comparing
    deviceFwVersion vs latestFwVersion so dashboard does not show
    a permanent false 'Update Available' badge after a successful OT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
    [firmware.ino]
2026-08-26 fix: revert to ESP32 core 2.x LEDC API
    [firmware.ino]
2026-08-28 fix: missed scheduled-dispense notifications + schedule runner bugs
    - Add onConnect hook to useSocket for reconnect catch-up fetch
    - Track seenFeedingIds (Set) to deduplicate; pre-seed from initial load
    - Gate onConnect catch-up behind initSeeded flag to avoid race on first connect
    - Remove dead oldWeight/currentWeight vars from setStatus
    - Move firedThisMinute.add() after device-online check so offline skips can retry
    - Wrap schedule MQTT publish in error callback; Firestore + socket event only fire on confirmed delivery
2026-09-01 feat: add date to system notifications and ESP32 event log
    - System notifications: store and display 'Sep 1, 2026 · HH:MM:SS'
    - date field added to alert record so it persists in Firestore
    - Graceful fallback: old records without date field show time only
    - ESP32 event log: show 'Sep 1, 2026 · HH:MM AM/PM' per feeding row
2026-09-01 fix: widen event log timestamp column to fit date + time
    .history-row-compact timestamp column was fixed at 75px — too narrow
    for the new 'Sep 1, 2026 · 12:55 PM' format (~160px needed).
    Switched to minmax(160px, max-content) so the column auto-sizes
    to its content without overflow. Responsive breakpoint updated too.
2026-09-01 fix: stop spurious reservoir alerts on reload + show dates on all notifications
    Bug 1+2: prevFoodState.current is now seeded from the initial /status
    fetch. Since the ref is pre-populated with the current band, the first
    live socket update is ignored (same state) and no notification fires
    on page load or reconnect. This also stops the double-fire sequence
    (EMPTY -> LOW) seen on every reload.
    Bug 3: Old Firestore notifications have no 'date' field because they
    were saved before the date field was added. The render now derives the
    date from the notification id (which always starts with Date.now() ms),
    so every existing and future record shows a correct date.
2026-09-01 fix: truly prevent spurious reservoir notifications on every reload
    Root cause: the reservoir useEffect fires on initial mount with
    food_level:0 (default state) before the /status fetch completes.
    prevFoodState is null at that point, so null !== 'empty' fires an alert.
    The previous seed-in-init fix was too late — it ran AFTER the effect
    already fired for the initial render.
    Fix: add a statusReady ref (starts false) that gates the reservoir
    useEffect entirely. Both statusReady and prevFoodState are set
    synchronously BEFORE calling handleStatusUpdate (which schedules the
    setStatus re-render). By the time React processes that re-render and
    re-fires the effect, both refs are already correct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
2026-09-01 fix: recalibrate HOPPER_EMPTY_CM from 11 to 9 cm
    Physical empty was showing 23% instead of 0%.
    Back-calculation from the observed reading:
    23 = 100 - (dist - 2) * 100 / (11 - 2) → dist ≈ 9 cm
    The sensor reads ~9 cm at true empty, but HOPPER_EMPTY_CM was 11,
    so the map() never reached 0%. Setting it to 9 maps the physical
    empty reading to exactly 0%. constrain() clamps any reading beyond
    9 cm to 0% as well, handling sensor variation.
    [firmware.ino]
2026-09-01 chore: bump firmware version 1.3.12 -> 1.3.13
    Triggers compile-firmware workflow to build and deploy updated
    binary with recalibrated HOPPER_EMPTY_CM (11->9 cm) fix.
    [firmware.ino]
2026-09-01 docs: comprehensive README update
    - Updated project structure (useNotifications.js, sw.js, hooks)
    - Added CI/CD section documenting compile-firmware.yml workflow
    - Added Notification System section with all 4 alert types/colors
    - Added reservoir band thresholds (FULL/SUFFICIENT/LOW/EMPTY)
    - Added OS-level push notification (service worker) flow
    - Added notification persistence schema (id, type, title, message, time, date)
    - Updated firmware constants table with current values (v1.3.13)
    - Updated HOPPER_EMPTY_CM calibration history (20→11→9 cm) with back-calc formula
    - Added troubleshooting entries for reload notifications, missing dates, CI failures
    - Updated MQTT payload example to show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
2026-09-01 fix(firmware): v1.3.14 - servo de-energize, ultrasonic rate-limit, stale comment fix
    - De-energize servo after setup settle and after each DISPENSE_EVALUATE cycle to prevent motor heating and idle jitter
    - Rate-limit ultrasonic reads to every 500 ms (was every loop tick); getDistance() blocks ~30 ms so this keeps the main loop responsive
    - Fix stale comment: HOPPER_EMPTY_CM was labelled 20, actual value is 9
    [firmware.ino]
2026-09-01 fix: re-energize servo LEDC timer on each dispense (v1.3.15)
    DISPENSE_EVALUATE cuts PWM with ledcWrite(SERVO_CHANNEL, 0) to prevent
    idle heating. On ESP32 Core 2.x this halts the LEDC timer entirely, so
    the next ledcWrite() in closeHopper() silently does nothing and the servo
    never moves.
    Fix: call ledcAttachPin(SERVO_PIN, SERVO_CHANNEL) at the start of
    DISPENSE_INIT to restart the timer before any duty value is written.
    [firmware.ino]
2026-09-02 fix(netlify): require auth on serverless functions, fix MQTT topic and profile fields
    All Netlify functions (feed, schedules, schedules-id, profile, feedings-*,
    sensor-history, status) were missing the JWT check server.js enforces on the
    identical routes, letting anyone reach the Netlify deployment trigger a
    dispense, edit/delete schedules, or overwrite the profile with no auth
    header. Add a shared requireAuth() helper (verifies the same Bearer JWT) and
    wire it into every handler.
    Also fix two smaller bugs found alongside it:
    - feed.js's default MQTT_TOPIC_CMD didn't match the device's actual command
    topic, so feed requests through this path silently never reached it.
    - profile.js dropped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
2026-09-02 fix(firmware): guard overlapping feed commands, report OTA parse failures (v1.3.16)
    dispenseByWeight() had no guard against firing while a dispense was already
    running (dispState != DISPENSE_IDLE): a scheduled feed, button press, or
    duplicate MQTT command arriving mid-cycle would unconditionally clear
    systemJammed and restart the state machine, risking overfeeding or forcing
    the auger against an unresolved jam. Now overlapping requests are ignored.
    checkForOTAUpdate() also returned silently on a malformed version.json
    without publishing a terminal status, leaving the dashboard's OTA badge
    stuck on "Checking..." indefinitely.
    [firmware.ino]
2026-09-02 fix(server): correct timezone double-shift in weekly/monthly feeding chart
    padDays() computed the correct LOCAL_TZ UTC-offset (matching the sibling
    getLocalCutoffISO helper) but then read/wrote dates with local Date methods
    (getDate/setDate) instead of UTC ones. When process.env.TZ is set to match
    LOCAL_TZ (as .env.example documents), those local methods already reflect
    the target timezone, so adding the offset on top double-shifted the date —
    mislabeling which calendar day a feeding's bar belongs to for part of each
    day. Switch to setUTCDate/getUTCDate, consistent with getLocalCutoffISO.
2026-09-02 fix(frontend): resync today's feed count at midnight, fix timeline label match
    feedingsToday was only ever incremented by 'feeding_done' socket events and
    never reset (the server never emits the 'feedings_today' event the UI also
    listens for), so a dashboard tab left open past local midnight kept counting
    yesterday's feedings into today's total. Poll for the Manila-local date
    rolling over and re-fetch /feedings/today when it does.
    Also fix the feeding timeline marking a schedule slot 'completed': it only
    matched on label, so two enabled schedules sharing a label could mark each
    other complete/missed off one feeding. Match on time too, since the server
    only fires a schedule at its exact HH:M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
2026-09-02 fix(firmware): fail fast when hopper is empty instead of running the full 35s timeout (v1.3.17)
    The dispense state machine had no way to detect "no food is coming out" —
    only IR-based jam detection, which never fires when the hopper is simply
    empty (nothing there to block the beam). So every dispense attempt with an
    empty hopper pulsed the auger uselessly for the full 35s hard timeout before
    giving up, and — now that overlapping feed commands are correctly ignored
    (see previous commit) — a retry during that window just did nothing, which
    looked like the feeder had stopped responding entirely.
    Track weight gain across pulses in DISPENSE_PULSE_SETTLE; after 4
    consecutive pulses with < 1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
    [firmware.ino]
2026-09-02 docs: bring README fully up to date with current code
    Verified every claim in the README against the actual code rather than
    just bumping version numbers, and found several stale/inaccurate spots:
    the "demo mode" feature doesn't exist anywhere in the code, the OTA MQTT
    payload example used fields (state/progress) the firmware never sends,
    and notifications don't actually get a persisted `date` field like the
    docs claimed. Also flagged dead code (_data.js, MetricPanels.jsx,
    useDashboard.js) and removed the rewrite_firmware.py reference.
    Documented this session's fixes in place: the LEDC timer-sharing gotcha
    behind the servo bug, the new non-blocking dispense state machine's
    stall-detection c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
2026-09-11 fix(firmware): prevent dispense state wedge and targetWeight races (v1.3.18)
    - Exclude FINAL_SETTLE/EVALUATE from the 35s hard-timeout check, which
    previously kept re-triggering every call forever and permanently wedged
    the state machine off DISPENSE_IDLE once a dispense ran past 35s.
    - Reset dispTrickleTimer when the anti-jam sequence reopens the hopper,
    instead of closing it again almost instantly on the next tick.
    - Replace the empty-hopper stall abort's unconditional success override
    with a minimum-weight check in DISPENSE_EVALUATE: fixes a regression
    where a dispense that had already reached its target near completion
    could be misreported as failed, while still catching the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
    [firmware.ino]
2026-09-11 fix(server): harden feed/tare/schedule/notification endpoints
    - Fix falsy-zero bug (data.portion_g || 100) and NaN poisoning in the
    physical-feed MQTT log handler.
    - Clamp portion_g to [1,500] and reject empty label/time in
    PATCH /schedules/:id, matching the validation POST already has.
    - Stop POST /notifications from accepting a client-supplied id, which let
    any caller overwrite an existing notification via .set(); also persist
    the date field it was silently dropping.
    - Chunk DELETE /notifications into <=500-doc batches (Firestore's hard
    per-batch write limit).
    - Fix a schedulesCache invalidation race where a write landing mid-fetch
    could have its invalidation silently clobbered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
2026-09-12 fix(firmware): loosen empty-hopper stall detector, debounce ultrasonic jumps (v1.3.19)
    - Raise DISPENSE_STALL_PULSES 4->10 and lower DISPENSE_STALL_GAIN_G 1.0->0.2g.
    Confirmed in the field: a 45g request was reported "HOPPER EMPTY" after only
    ~3s, having actually dispensed 35-37g. Every pulse below ~12.5g remaining is
    floor-clamped to PULSE_MIN_MS, so the final approach to target is inherently
    slow trickle, not a sign of an empty hopper — the old 4-pulse/1.0g bar was
    too impatient for that regime. New values still detect a truly empty hopper
    in ~8s worst case, far faster than the 35s hard timeout this replaced.
    - Debounce large jumps in the ultrasonic level reading the same way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
    [firmware.ino]
2026-09-12 fix(firmware): shorten pulse settle wait in the final approach to target (v1.3.20)
    Once remaining <= DISPENSE_FINE_APPROACH_G (5g), use PULSE_SETTLE_FAST_MS
    (350ms) instead of the normal 700ms wait between pulses, so the last stretch
    of a dispense finishes faster in wall-clock time.
    Tradeoff (requested/accepted): PULSE_SETTLE_MS exists so the load cell reads
    a mechanically-stable number before the next pulse is sized off it — cutting
    it risks reading mid-vibration and mis-sizing (or mis-timing the stall
    counter for) the next pulse. If the tail becomes less accurate or the stall
    detector starts misfiring again, raise PULSE_SETTLE_FAST_MS back up rather
    than reverting this outright.
    Co-Aut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
    [firmware.ino]
2026-09-12 fix(frontend): improve mobile responsiveness of the dashboard
    Found and verified live at 390px (iPhone width) with mock data via a
    headless-browser check, not just CSS review:
    - Feeding timeline: schedules within 45 min of each other previously
    overlapped into an unreadable merged marker. Greedily assign each
    marker a row (interval-graph-coloring style) so close-together
    schedules stack instead of visually merging, at any screen width.
    - Feeding timeline: marker labels (schedule name/portion/time) were only
    reachable via CSS :hover, which touch devices have no equivalent for.
    Tapping a marker now toggles a .label-active class that shows the same
    label, in addition to hover for m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
2026-09-12 fix(frontend): cap System Notifications card height like the ESP32 log
    Was using flex:1 (grows to fit all content); switched to the same fixed
    height: 300px the ESP32 Event Log card already uses, so it scrolls
    internally instead of stretching the layout as notifications pile up.
    Verified: with 8 mock notifications the card measures exactly 300px and
    shows the rest via the existing overflowY:auto history-list.
2026-09-12 fix(frontend): size System Notifications card to content, cap at 300px
    Previous commit forced a fixed height:300px matching the ESP32 log card,
    which padded the notifications card out to a big mostly-empty box with
    only 1-2 notifications. Switched to maxHeight:300px instead: the card
    now sizes to its actual content (verified: 203px with 1 notification)
    and only caps + scrolls once content would exceed 300px (verified: still
    300px with 8 notifications) - matching the intended behavior (bounded,
    not unbounded growth) without forcing the same literal size as ESP32 log.
2026-09-12 fix(server,frontend): create notifications server-side so they survive a closed dashboard
    Previously every "System Notifications" entry (dispense, device fault,
    reservoir level change) was created entirely client-side — addAlert() ran
    only in an open, connected browser tab, so nothing was ever recorded if no
    dashboard was open when the event happened. A 5-minute reconnect catch-up
    covered dispenses only, and only within that narrow window.
    server.js: added createNotification(), which persists to Firestore and
    broadcasts a new 'notification' socket event, called at the exact moment
    each event happens server-side:
    - All four feed-success paths (REST /feed, socket feed, physical-button
    MQT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
2026-09-12 fix(frontend): stop dashboard from overflowing horizontally on mobile
    .dashboard-layout sets justify-content:center, which makes a bare 1fr grid
    track size by its content's max-content width (how wide it'd be if nothing
    ever wrapped) instead of stretching to fill the viewport. Any single
    unconstrained text run in the column — traced to a notification message
    span, though the chart header and schedule-management rows contribute too
    - was enough to inflate the track 25-50px past the screen edge, forcing
    the whole page into horizontal scroll.
    Changed grid-template-columns: 1fr -> minmax(0, 1fr) on both affected
    breakpoints (1200px and 992px). Standard fix for this exact CSS Grid
    behavior; ch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
